juw12/trunnion-topopt/models/trunnion_upright_v0_naive_baseline.stl

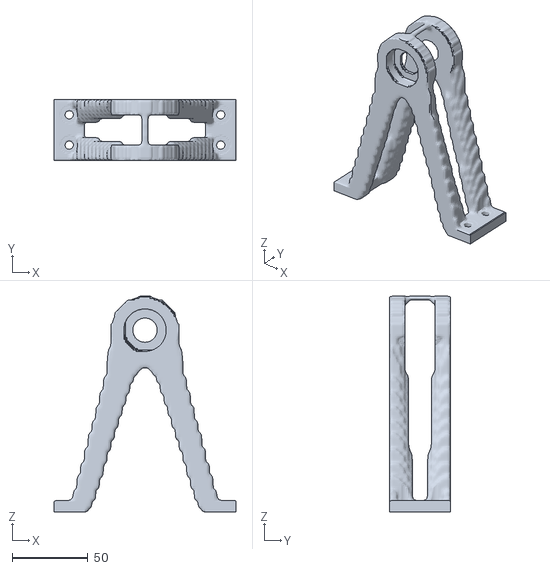
[picture p2: CAD file, 2026-11-08]
models/trunnion_upright_v0_naive_baseline.stl
120.0 x 40.0 x 142.6
