juw12/trunnion-topopt/models/trunnion_upright_v4_final.stl

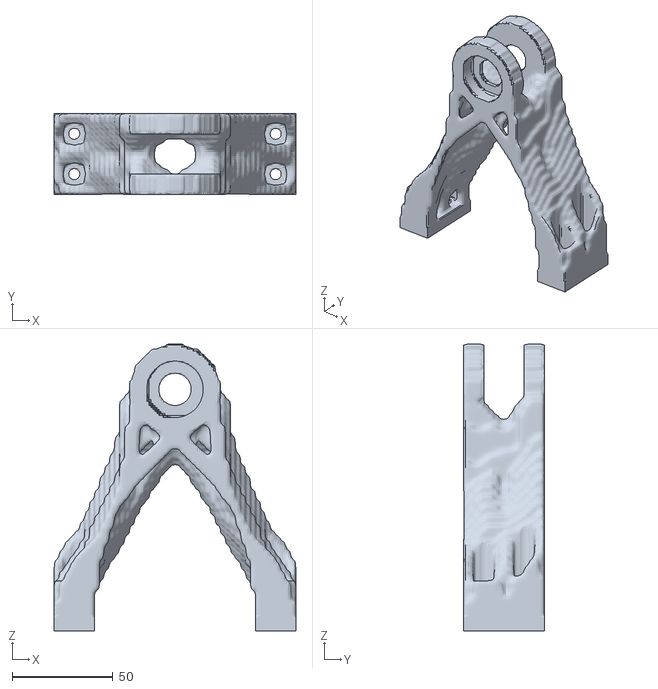
[picture p3: CAD file, 2026-11-08]
models/trunnion_upright_v4_final.stl
120.0 x 40.0 x 142.5
