juw12/trunnion-topopt/models/trunnion_upright_v2_final.stl

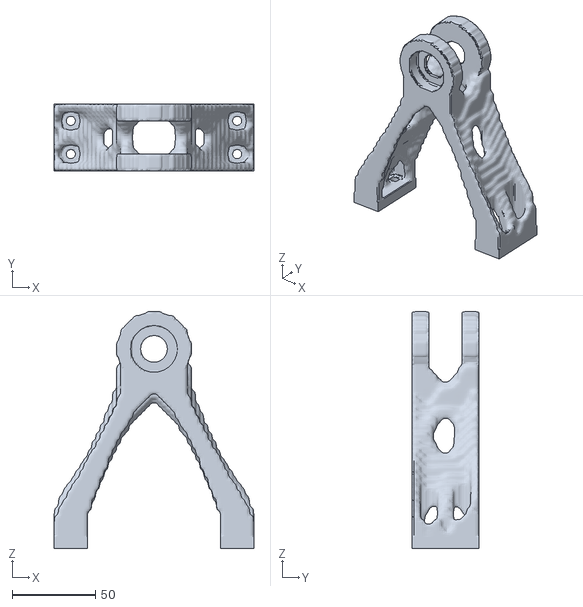
[picture p4: CAD file, 2026-11-08, an earlier design]
models/trunnion_upright_v2_final.stl
120.0 x 40.0 x 142.5
